comcon1/karabas/description.txt

Карабас - устройство для дерганья крыс переменным током с частотой 50 Гц и
регулируемым напряжением.

Кроме основного ствола, имеется одна ветка - *wmaket_lovat*, где выложена схема
первичного рабочего макета, собранного для Ловатя.
