comcon1/karabas/corpus/DOC000273986.pdf

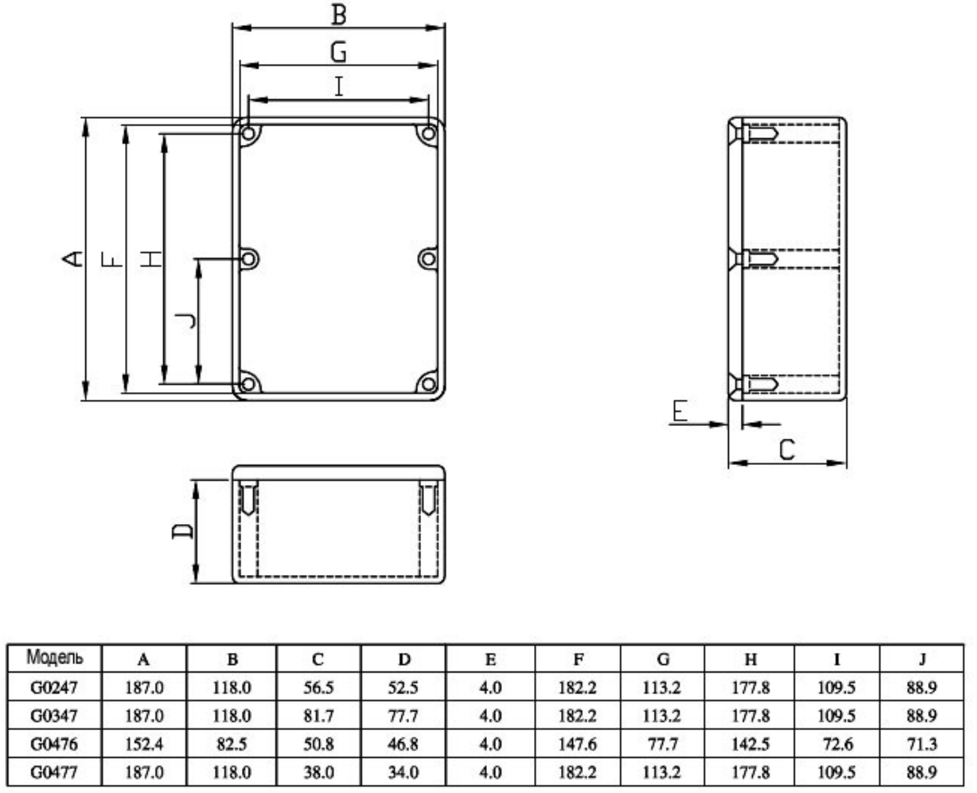
[picture p1: page 1]
