comcon1/karabas/corpus/corpus0.dxf

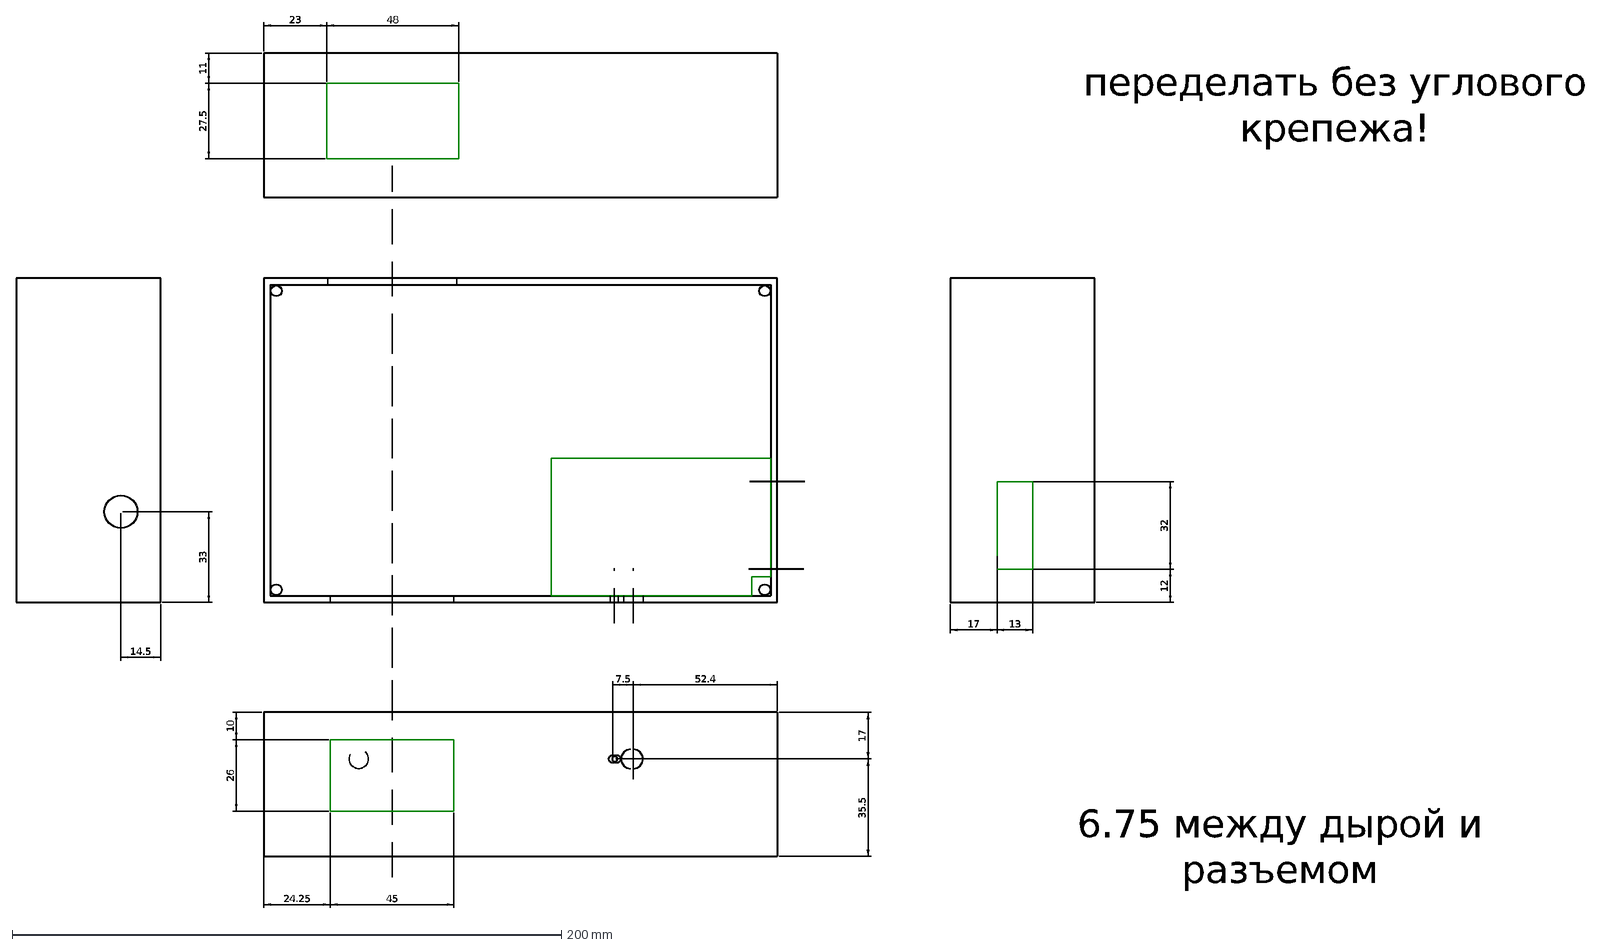
[picture p2: CAD file, 2016-04-06]
corpus/corpus0.dxf
12
45
10
26
24.25
17
52.4
35.5
6.75 между дырой и разъемом
переделать без углового крепежа!
11
23
27.5
48
7.5
32
13
14.5
33
