comcon1/karabas/kicad/ESL-scourge.kicad_pcb

## KiCad design kicad/ESL-scourge.kicad_pcb (2016-04-11)

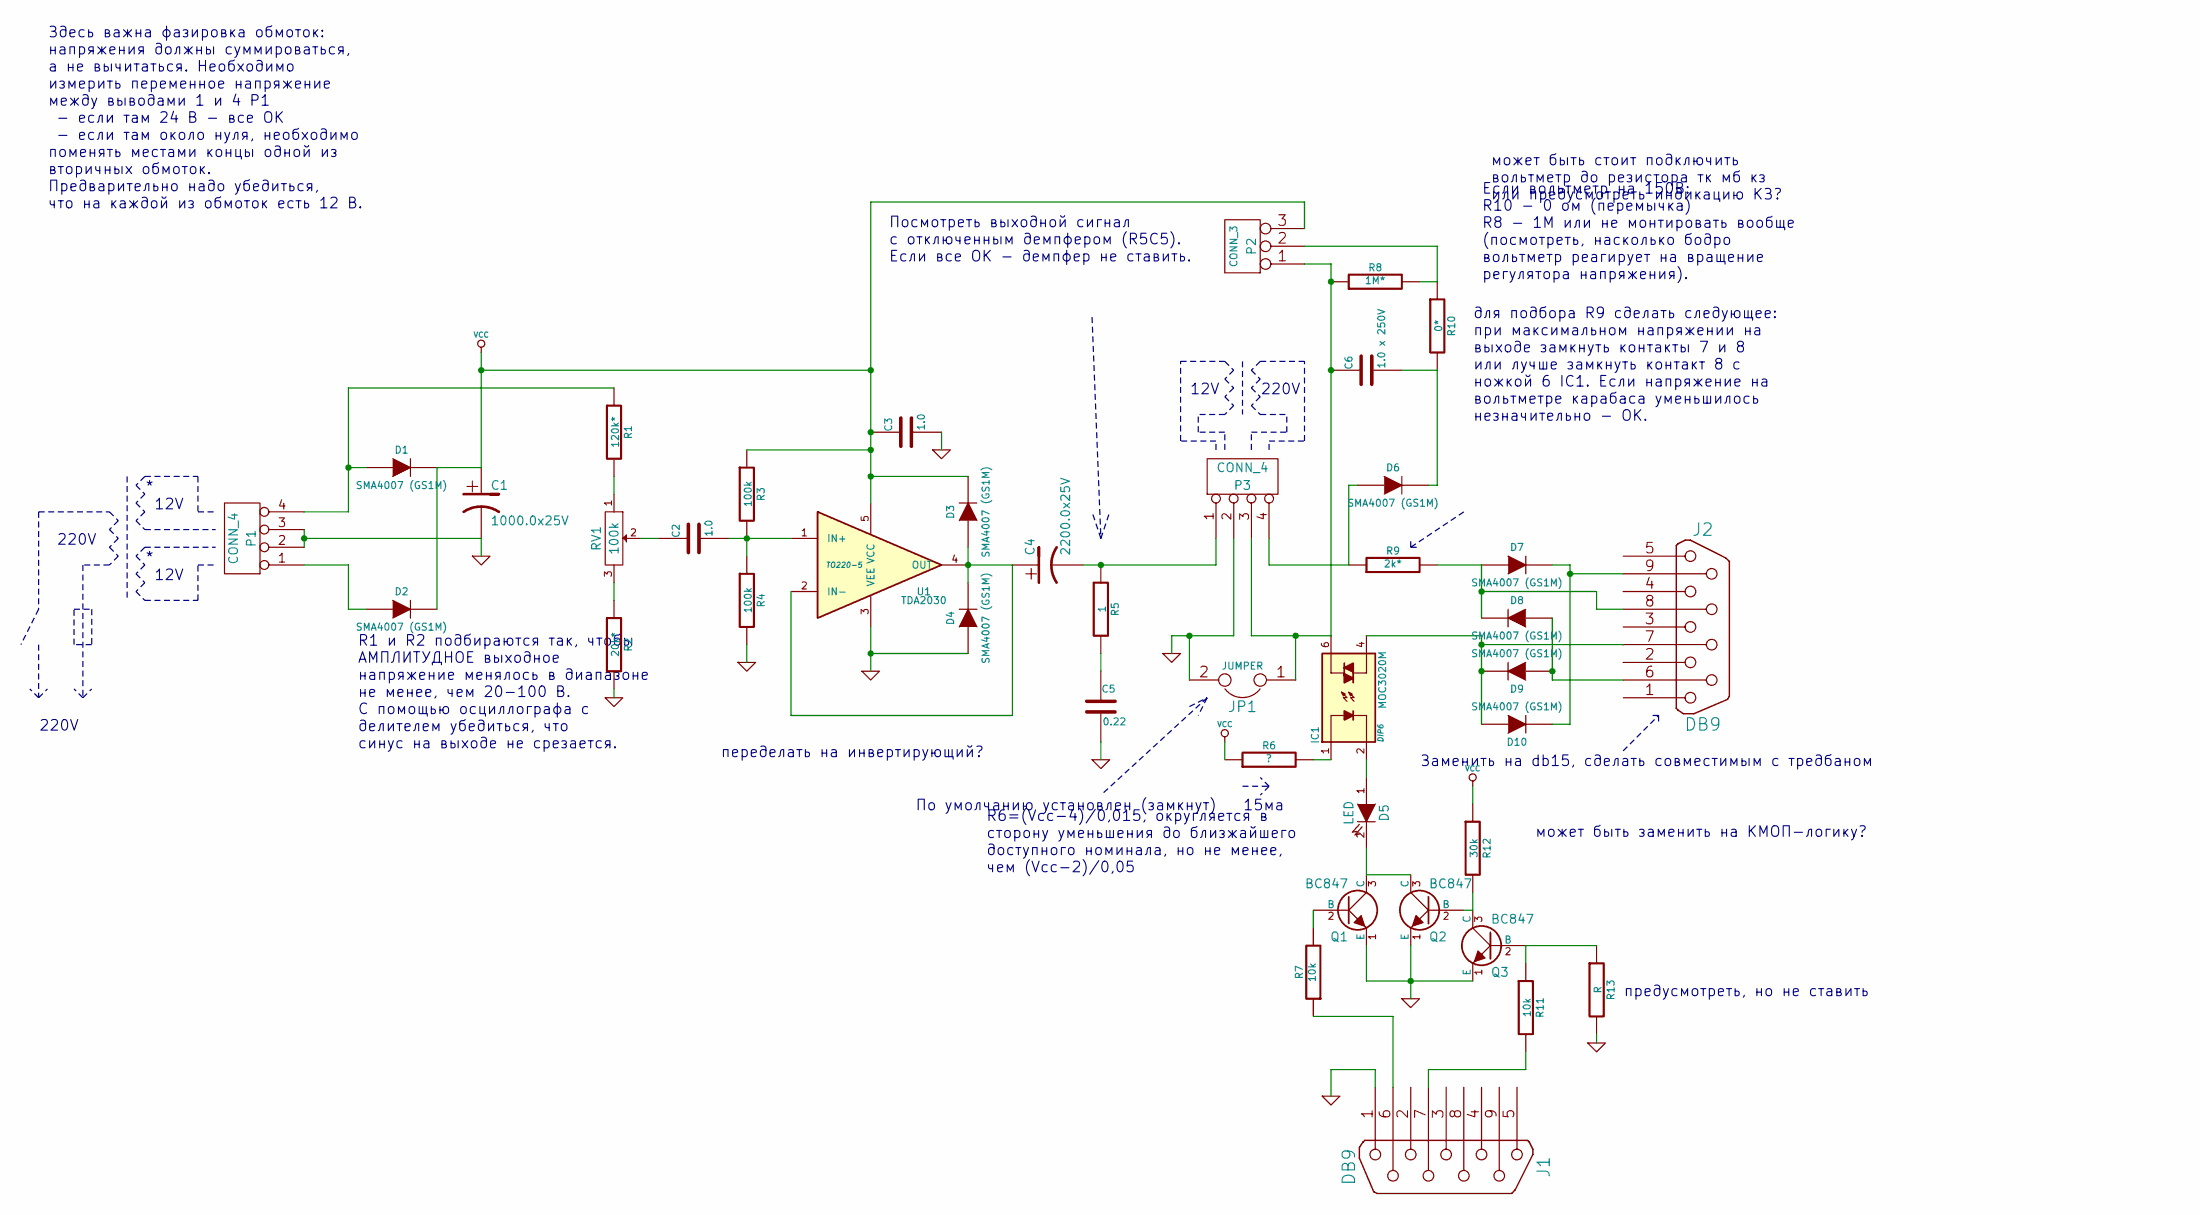
[picture p3: schematic ESL-scourge.sch]

Parts:
C1: 1000.0x25V
C2, C3: 1.0
C4: 2200.0x25V
C5: 0.22
C6: 1.0 x 250V
D1, D2, D3, D4, D6, D7, D8, D9, D10: SMA4007 (GS1M)
D5: LED
IC1: MOC3020M; DIP6
J1, J2: DB9
JP1: JUMPER
P1, P3: CONN_4
P2: CONN_3
Q1, Q2, Q3: BC847
R1: 120k*
R2: 20k*
R3, R4: 100k
R5: 1
R6: ?
R7, R11: 10k
R8: 1M*
R9: 2k*
R10: 0*
R12: 30k
R13: R
RV1: 100k
U1: TDA2030; TO220-5

Connections:
GND: C1.2, C3.2, C5.2, D4.1 (A), J1.1, JP1.2, P1.2, P1.3, P3.2, Q1.1 (E), Q2.1 (E), Q3.1 (E), R2.2, R4.2, R13.2, U1.3 (VEE)
unnamed: D7.1 (A), D8.2 (K), J2.8, R9.2
unnamed: D7.2 (K), D10.2 (K), J2.9
unnamed: P2.2 (PM), R8.2, R10.1
unnamed: C2.2, R3.2, R4.1, U1.1 (IN+)
unnamed: C4.1, D3.1 (A), D4.2 (K), U1.2 (IN-), U1.4 (OUT)
unnamed: D5.2 (K), Q1.3 (C), Q2.3 (C)
unnamed: C5.1, R5.2
unnamed: C2.1, RV1.2
unnamed: R2.1, RV1.3
unnamed: R1.2, RV1.1
unnamed: D1.1 (A), P1.4, R1.1
unnamed: D6.1 (A), P3.4, R9.1
unnamed: D2.1 (A), P1.1
unnamed: Q2.2 (B), Q3.3 (C), R12.2
unnamed: Q3.2 (B), R11.1, R13.1
unnamed: IC1.1, R6.2
unnamed: D5.1 (A), IC1.2
unnamed: J1.7, R11.2
unnamed: J1.6, R7.1
unnamed: Q1.2 (B), R7.2
unnamed: C6.2, D6.2 (K), R10.2
unnamed: C4.2, P3.1, R5.1
unnamed: C6.1, IC1.6, JP1.1, P2.1, P3.3, R8.1
unnamed: D8.1 (A), D9.1 (A), J2.6
unnamed: D9.2 (K), D10.1 (A), IC1.4, J2.7
VCC: C1.1, C3.1, D1.2 (K), D2.2 (K), D3.2 (K), P2.3, R3.1, R6.1, R12.1, U1.5 (VCC)

Notes on the sheet:
переделать на инвертирующий?
может быть стоит подключить вольтметр до резистора тк мб кз или предусмотреть индикацию КЗ?
15ма
может быть заменить на КМОП-логику?
Заменить на db15, сделать совместимым с тредбаном
12V
220V
Здесь важна фазировка обмоток: напряжения должны суммироваться, а не вычитаться. Необходимо измерить переменное напряжение между выводами 1 и 4 P1 - если там 24 В - все ОК - если там около нуля, необходимо поменять местами концы одной из вторичных обмоток. Предварительно надо убедиться, что на кажд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
R6=(Vcc-4)/0,015, округляется в сторону уменьшения до близжайшего доступного номинала, но не менее, чем (Vcc-2)/0,05
По умолчанию установлен (замкнут)
для подбора R9 сделать следующее: при максимальном напряжении на выходе замкнуть контакты 7 и 8 или лучше замкнуть контакт 8 с ножкой 6 IC1. Если напряжение на вольтметре карабаса уменьшилось незначительно - ОК.
Если вольтметр на 150В: R10 - 0 ом (перемычка) R8 - 1M или не монтировать вообще (посмотреть, насколько бодро вольтметр реагирует на вращение регулятора напряжения).
R1 и R2 подбираются так, чтобы АМПЛИТУДНОЕ выходное напряжение менялось в диапазоне не менее, чем 20-100 В. С помощью осциллографа с делителем убедиться, что синус на выходе не срезается.
Посмотреть выходной сигнал с отключенным демпфером (R5C5). Если все ОК - демпфер не ставить.
предусмотреть, но не ставить

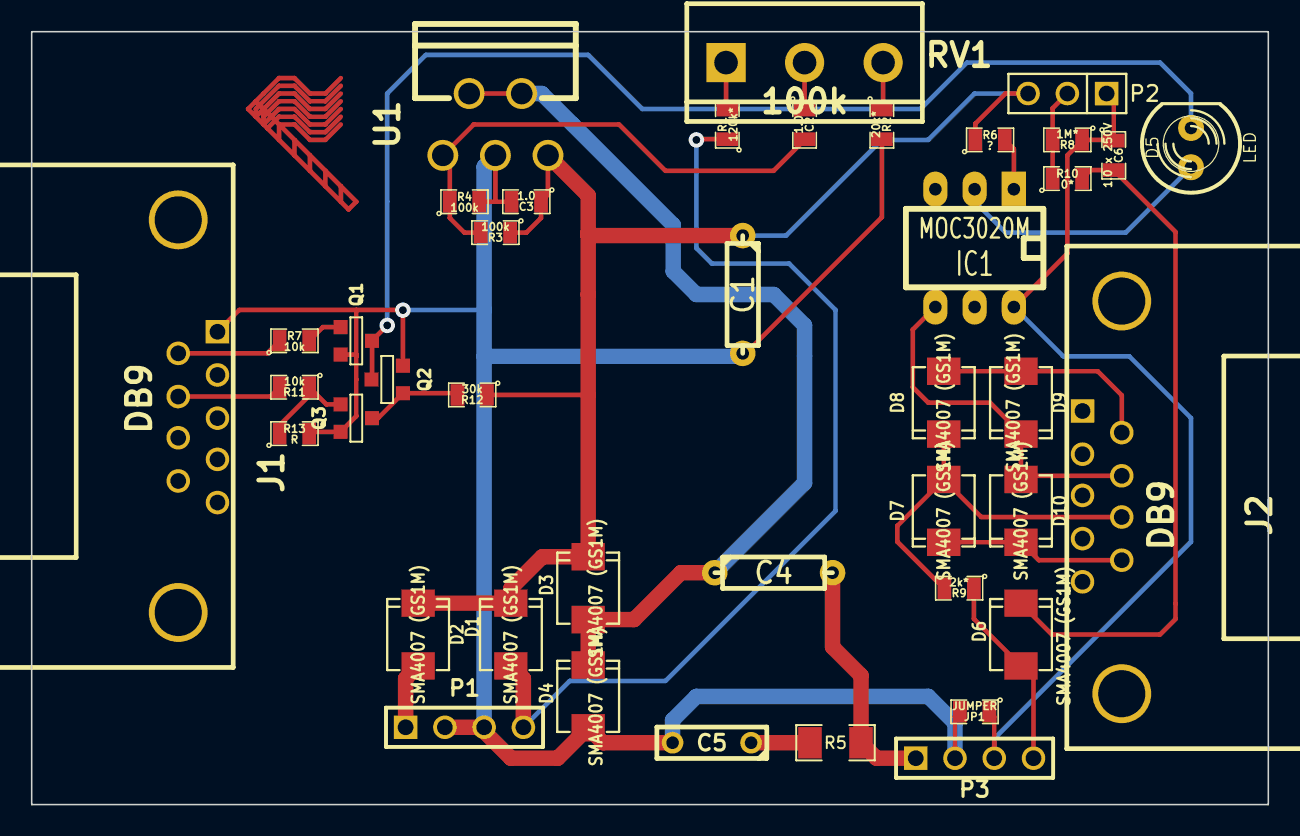
[picture p4: board ESL-scourge.kicad_pcb from above]

Board: 2 copper layers, 80.0 x 50.0 mm, 41 parts (0 on the bottom side), 27 nets.
