comcon1/karabas/(commit log)

2016-02-22 Major version made by kuzya at 21/02/16
    [ESL-scourge.kicad_pcb, ESL-scourge.sch]
2016-02-23 Bug in pcb fixed
    [ESL-scourge.kicad_pcb]
2016-02-23 Silks layer corrected
    [ESL-scourge.kicad_pcb]
2016-04-01 Comments for debugging added
    [ESL-scourge.sch]
2016-04-02 Critical bug fixed in power supply circuit - wrong diode polarity
    [ESL-scourge.kicad_pcb, ESL-scourge.sch]
2016-04-04 corpus - variant zero. Need for pcb to be redesigned. Transformator was changed but not comitted yet.
    [corpus0.dxf]
2016-04-06 fixed bugs of the first corpus
    [corpus0.dxf]
2016-04-11 Several critical bugs fixed - wrong diode polarity in output bridge, pullup resistors added in slon-control scheme
    [ESL-scourge.kicad_pcb, ESL-scourge.sch]
2016-05-02 component values corrected. Work in progress
    [ESL-scourge.sch]
